frederic-fradin/default-project/desktop-tool/images/desktop-1.jpg

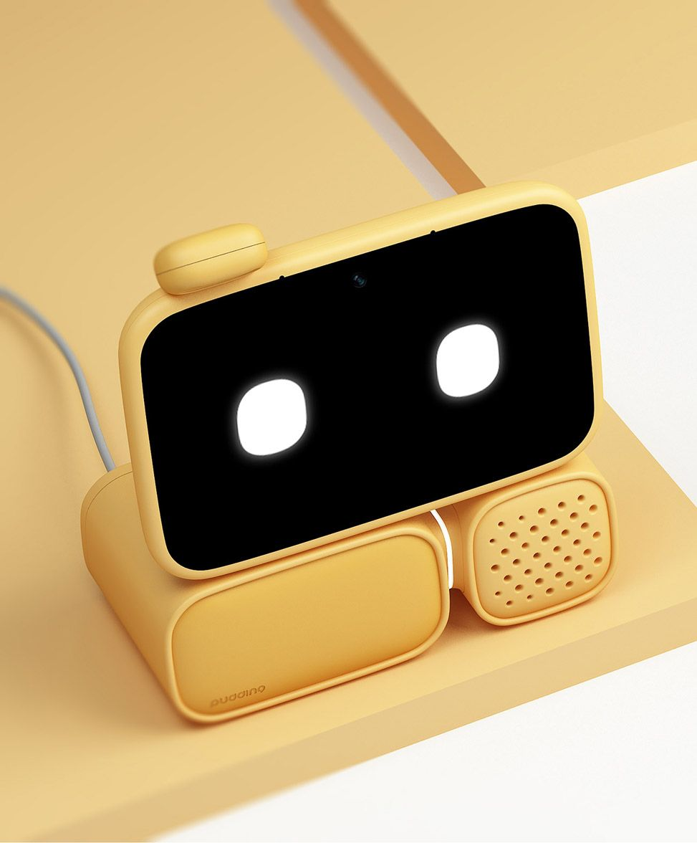
desktop-tool/images/desktop-1.jpg
