frederic-fradin/default-project/desktop-tool/images/desktop-7.jpg

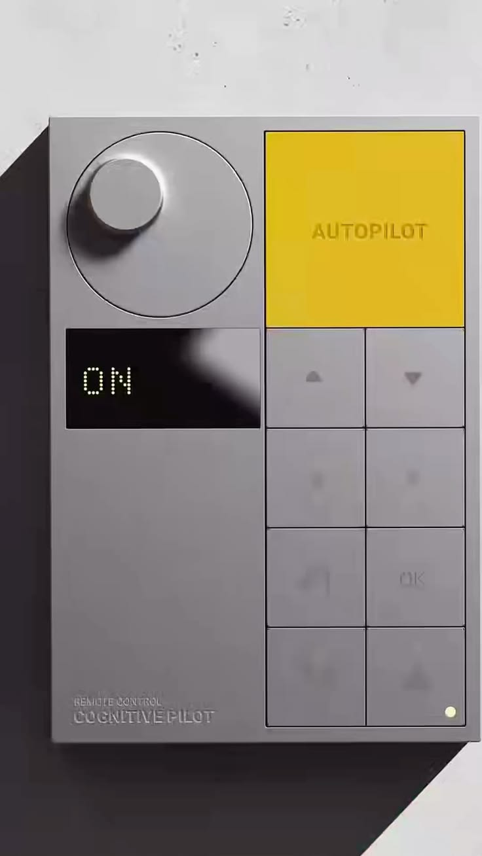
desktop-tool/images/desktop-7.jpg
