frederic-fradin/default-project/desktop-tool/README.md

# desktop-tool

Objet physique de bureau, évolutif, conçu et fabriqué de A à Z : boîtier imprimé en 3D
(Bambu Lab A1), électronique intégrée, fonctionnalités programmées.

Document de référence : [docs/cadrage.md](docs/cadrage.md)

## Arborescence

| Dossier | Contenu |
|---|---|
| `docs/` | Cadrage, journal de bord, notes techniques |
| `docs/decisions/` | Décisions structurantes (une fiche par décision, format ADR léger) |
| `cad/` | Modèles 3D sources (CAO), exports STL/3MF, profils d'impression |
| `hardware/` | Nomenclature (BOM), schémas de câblage, fiches composants |
| `firmware/` | Code embarqué de l'objet |
| `companion/` | Application compagnon Python sur le PC et simulateur de l'objet ([README](companion/README.md)) |
| `images/` | Images de référence pour le design |
