frederic-fradin/default-project/desktop-tool/docs/design/maquette-encombrement.html

desktop-tool · maquette P1 · cotes en mm

# Maquette d'encombrement du module

Le module complet en paysage (ADR 006) à l'échelle réelle : 125 × 115 × 26 mm, dos ouvert. On y monte toutes les vraies pièces (carte T5 avec son écran, NeoKey et ses 4 touches, molette, câbles QT, câble USB-C) pour vérifier que tout tient (risque R10), par où passent les câbles et où reste la place de la batterie v2. Le bas reprend le coin de module validé. Les cotes de la carte T5 viennent du plan officiel LilyGO (shell/EPD47-S3.dxf) et celles de l'écran de la fiche E Ink ED047TC1 : elles sont provisoires jusqu'à la réception de la carte.

## Façade, vue de face

échelle 2,2:1origine : coin bas gauchecarte T5 : USB-C à droite

Carte T5. 118,07 × 63,07 mm pour 120 mm de place entre les parois : moins de 1 mm de jeu de chaque côté. Elle est centrée en largeur et posée à y_t5 = 44 du bord bas, ce qui met l'écran à 10 mm du bord haut, comme sur la maquette validée. Ses coins restent sous les arrondis du haut (107 < 108) : pas de conflit avec les congés intérieurs.

Écran. La zone active (103,68 × 58,32) n'est pas centrée sur la dalle : 8,1 mm de bord côté nappe (à gauche) contre 2,1 de l'autre. Avec la carte centrée, la fenêtre a donc un bord gauche de ≈ 13 mm et un bord droit de ≈ 7,5 mm : elle s'aligne à droite sur les capuchons des touches.

Composants au dos de la carte (pointillés) : tous sont côté dos, l'avant ne porte que l'écran. Le connecteur 2×20 longe le bas de la carte, juste au-dessus de la rangée de touches ; l'échancrure du bas est sous l'antenne de l'ESP32.

## Coupe B-B, dans l'axe des broches I²C

échelle 2,4:1x = 74, vue de droite

Épaisseur. Sous la façade, l'écran et la carte occupent ≈ 2,5 mm. Il reste ≈ 21 mm jusqu'au dos, dos compris : assez pour les composants de la carte (ESP32 3,1 mm), une batterie v2 de 5 mm et les câbles.

Le point dur : le câble I²C. Le câble 4209 se branche sur le connecteur femelle 2×20, qui dépasse déjà de ≈ 8,5 mm au dos de la carte. Le boîtier noir de ses broches mâles ajoute ≈ 14 mm, plus le rayon du fil : il sortirait de ≈ 6 mm sous le dos. Valeurs standard, à confirmer en mesurant le câble dès maintenant et le connecteur à réception.

### Carte T5 · ce que dit le plan officiel

Élément | Cote | Source
Carte | 118,07 × 63,07 × 1,6 | Plan LilyGO. Le site annonce 121 × 67 × 12 : à mesurer
Échancrure sous l'antenne | 20 × 7,25 | Plan LilyGO, bord bas, à 89,7 du bord gauche
Dalle de l'écran | 113,9 × 62,5 × 0,87 | Fiche E Ink ED047TC1
Zone active | 103,68 × 58,32 | Fiche E Ink ; bords 8,1 côté nappe, 2,1 à l'opposé, ≈ 2,1 en haut et en bas
Position de la dalle sur la carte | ? | Supposée centrée : à mesurer
USB-C | centre à 39,3 du bas | Sur le petit côté droit, il dépasse la carte de ≈ 1 mm
Connecteur 2×20 (SDA 18, SCL 17) | x 26 → 76, y 1,4 → 5,8 | Au dos, le long du bord bas ; broches 17/18 vers x ≈ 70
Prise P5, PH 2,0 4 broches | x 27,6 → 36,6, en haut | Schéma V2.3 : 3,3 V, IO15, IO16, GND
Prise P4, PH 2,0 4 broches | x 38,4 → 47,3, en haut | Schéma : 3,3 V, MISO, SCLK, GND (bus SPI)
Boutons RST, BOOT, IO | bord haut | Au dos : inaccessibles une fois le dos fermé
Trous de fixation | aucun | Aucun trou sur le plan : la carte sera tenue par des pattes

Positions données depuis le coin bas gauche de la carte, vue de face, USB-C à droite.

### Choix (2026-10-04)

#### 1 · Sens de la carte ✅

Retenu : USB-C à droite, connecteur 2×20 en bas. Le câble sort du côté opposé à la main gauche, et le connecteur I²C est près des touches. L'autre sens (USB-C à gauche) inverserait aussi les bords de l'écran (≈ 7,5 à gauche, ≈ 13 à droite).

#### 2 · Branchement I²C ✅

Boîtier des broches du 4209 mesuré à 14 mm : il ne tient pas. Retenu : prise P5 (IO15/IO16), avec le câble Adafruit 4424, JST PH 4 broches ↔ STEMMA QT (≈ 3 €, hors budget accepté). Ordre des fils à refaire avant de brancher (voir hardware/bom.md). Elle est basse, en haut de la carte, et l'ESP32-S3 accepte l'I²C sur n'importe quelles broches (Wire.begin(15, 16)). Écarté : le câble 4209 avec une fente dans le dos.

#### 3 · Hauteur de l'écran ✅

Retenu : y_t5 = 44, l'écran à 10 mm du bord haut, comme la maquette validée, avec ≈ 16 mm entre les capuchons et le bas de l'écran. Plus bas (y_t5 = 34, le minimum à cause des plots de la molette), l'écran se rapproche des touches mais le bord haut passe à ≈ 20 mm.

#### 4 · Constat : USB-C sur le côté

L'USB-C de la carte sort par le côté droit, pas au dos comme prévu par les ADR 005 et 006 (branchement par la lame de la station). Rien à décider tant que la station est en attente, mais il faudra mettre ces ADR à jour.

### Paramètres à ajouter · fichier module-maquette

Nom | Valeur | Rôle
h_module | 115 mm | Remplace h_test (40) : hauteur du module
l_t5 | 118,07 mm | Longueur de la carte T5 (à mesurer)
w_t5 | 63,07 mm | Largeur de la carte T5 (à mesurer)
x_t5 | 3,465 mm | Formule (l_module - l_t5) / 2 : carte centrée
y_t5 | 44 mm | Bas de la carte depuis le bord bas (écran à 10 mm du bord haut)
ep_t5_avant | 2,5 mm | Écran 0,87 + carte 1,6 (à mesurer) : hauteur des plots de la carte
aa_l / aa_h | 103,68 / 58,32 mm | Zone active de l'écran (fiche E Ink)
aa_x | 10,2 mm | Bord gauche de la zone active depuis le bord gauche de la carte (provisoire, à mesurer)
aa_y | 2,4 mm | Bas de la zone active depuis le bas de la carte (provisoire, à mesurer)
marge_fen | 0,5 mm | Fenêtre un peu plus grande que la zone active, de chaque côté
usb_y | 39,3 mm | Centre de l'USB-C depuis le bas de la carte (plan LilyGO)
usb_z | 19,4 mm | Axe de l'USB-C depuis le dos (provisoire, à mesurer)
usb_l / usb_h | 13 / 7,5 mm | Trou pour la fiche surmoulée du câble, jeu compris (à mesurer sur ton câble)

### Mesures à prendre

#### Dès maintenant

- Câble 4209 : longueur du boîtier noir d'une broche mâle, broche non comprise.
- Câble USB-C : largeur × épaisseur de la fiche surmoulée, et longueur avant le coude s'il est coudé.

#### À réception de la carte T5

- Longueur, largeur et épaisseur totale écran + carte, sans les composants.
- Position de la zone active (la partie qui change d'aspect) : distance aux 4 bords de la carte.
- Hauteur au dos : connecteur 2×20, ESP32, condensateur rond près de l'USB-C, prises P4/P5.
- USB-C : centre depuis le bas de la carte, hauteur de son axe depuis l'avant de l'écran, dépassement du bord.
- P5 : prise droite ou coudée, et ordre des fils (3,3 V, IO15, IO16, GND).
- Les bords haut et bas de la carte sont-ils libres de composants aux endroits des pattes ?

### Étapes dans Fusion · fichier module-maquette

1. Ouvrir coin-module, Fichier › Enregistrer sous module-maquette : le coin reste intact.
2. Modifier les paramètres : renommer h_test en h_module et le passer à 115, puis créer les paramètres ci-dessus.
3. Congé : double-clic sur le congé dans la timeline, ajouter les 2 arêtes verticales du haut. Les 4 coins sont arrondis à r_module.
4. Coque : double-clic sur la coque dans la timeline, désélectionner la face du haut et ne garder que le dos. Il reste la façade et 4 parois.
5. Fenêtre de l'écran : esquisse sur la façade, Rectangle 2 points, premier coin en x = x_t5 + aa_x - marge_fen, y = y_t5 + aa_y - marge_fen, de aa_l + 2 * marge_fen × aa_h + 2 * marge_fen. Couper de ep_paroi.
6. Plots de la carte : retourner la vue, esquisse sur la face intérieure de la façade, 4 cercles de d_plot : en bas à y = y_t5 - 3, x = 12 et 86,5 ; en haut à y = y_t5 + w_t5 + 2,7, x = 12 et 113. Extruder en « Joindre » de ep_t5_avant.
7. Avant-trous : d_pilote concentriques, Couper de 4. Il reste 1 mm de façade sous la vis.
8. Trou de l'USB-C : esquisse sur la face extérieure de la paroi droite, rectangle centré de usb_l × usb_h, à y_t5 + usb_y du bord bas et usb_z du dos. Couper de ep_paroi.
9. Enregistrer. Pas d'export avant la réception de la carte et la mise à jour des cotes provisoires.

### Tenue de la carte · pattes

La carte n'a pas de trou : 4 pattes imprimées à part la plaquent contre la façade par le dos. Chaque patte (8 × 10 × 2, trou Ø 2,4) se visse sur un plot de la carte et recouvre son bord de 2 mm. Les plots se placent hors de la carte, aux endroits libres de ses bords haut et bas (pas sur les côtés : moins de 1 mm de jeu). Serrer sans forcer : la dalle est en verre et ses coins sont fragiles.

### Impression

- À réception de la carte et après les mesures. 0.20mm Standard, plaque texturée, façade contre le plateau, 4 boucles de paroi, sans support. 125 × 115 tient sur le plateau de l'A1 (256 × 256).

### À noter après le test

- Carte : entre-t-elle entre les parois ? La fenêtre tombe-t-elle sur la zone active, sans bord blanc ni pixel caché ?
- Câbles : par où passent les câbles QT (carte → touches → molette) ? Rien ne force ?
- USB-C : la fiche entre-t-elle à fond par le trou de la paroi ?
- Place restante : une batterie 5 × 40 × 60 tient-elle derrière la carte, sous les câbles ?
- Prise en main : poids, équilibre, aspect de la façade avec l'écran.
