frederic-fradin/default-project/desktop-tool/docs/design/maquettes.html

desktop-tool · planches de conception · cotes en mm

# Le module et sa station modulaire

Le module se pose sur une station modulaire : un socle bas percé de trous ronds sur toute sa surface, sur lequel se clipsent le pupitre du module et le pupitre MagSafe du téléphone ; 2 colonnes restent libres pour un futur élément. La station prend la couleur du corps du module (ADR 005).

## Le module

retenu125 × 115 × 26 · paysagetouches neutres · ADR 004

Tourné de 90° vers la gauche après une impression test à l'échelle : écran en paysage en haut, molette en bas à gauche, sous le pouce gauche quand on le tient, et 4 touches en ligne en bas à droite. Dos plat avec 4 aimants et port USB-C. Les pointillés montrent la carte, la batterie (v2), le module de touches et l'encodeur. Touches à symboles neutres gravés en creux (1, 2, 3 barres, maison) ; leur fonction s'affiche en bas de l'écran, juste au-dessus de chaque touche.

## Style B · Muted White + orange

à confirmer par impression testsur la station modulaireteintes approximatives à l'écran

### Module

- Corps et touches : Muted White
- Symboles des touches : gravés en creux, sans couleur

### Accent

- Molette : Sunrise Orange

### Station

- Muted White, comme le corps du module : l'ensemble se lit comme un seul objet

## Style C · gris chaud + orange

d'après l'image desktop-9sur la station modulaireteintes approximatives à l'écran

### Module

- Corps : Ash Grey, gris mat
- Touches : Muted White, symboles fins gravés en creux, sans couleur

### Accent

- Molette : Sunrise Orange, seul point de couleur

### Station

- Ash Grey, comme le corps du module

## F · Station modulaire

piste retenuesocle 250 × 90 × 1048 trous ronds au pas de 20 mmiPhone 13 Pro en portrait

### Socle

- Dalle de 250 × 90 × 10 mm, aux arrondis du module : 12 colonnes, le maximum posé droit sur l'A1 (256 mm)
- Percée sur toute sa surface : 48 trous ronds Ø 10 × 6 mm (12 colonnes × 4 rangées), au pas de 20 mm, 15 mm de marge au bord
- Profondeur calée sur celle des semelles : un élément couvre les 4 rangées, aucun trou ne reste vide devant ou derrière lui
- Pas de rainure à stylo : un futur élément peut accueillir le stylo n'importe où
- Imprimé seul, à plat

### Élément · pupitre module

- 6 colonnes ; semelle de 3 mm et 4 tenons ronds clipsables aux coins (Ø 9,6 × 6, fendus, avec ergot)
- Lame d'appui à 65° avec renfort ; assise sous l'arête basse, face avant en pente douce jusqu'à la semelle
- Connecteur USB-C magnétique noyé dans la lame, face au port du dos du module ; câble en gorge au dos de la lame puis sous la semelle

### Élément · pupitre MagSafe

- 4 colonnes ; semelle de 3 mm et 4 tenons ronds aux coins
- Lame de 62 × 112 mm, empreinte Ø 56,5 × 5,5 pour le palet, centré à 75 mm du bas
- iPhone 13 Pro avec coque (74 × 149 × 12 mm) : il déborde de 6 mm de chaque côté de la lame, qui reste invisible de face
- Assise de 14 mm sous le téléphone, face avant en pente douce, sans rebord devant : le palet MagSafe suffit à le tenir

### Emplacement libre · 2 colonnes

- À droite du téléphone, ≈ 40 mm de large sur toute la profondeur
- Usage à définir : boîte à crayons, repose-stylo, vide-poche…
- Le support AirPods a été écarté

### Modularité

- Chaque élément se clipse n'importe où dans la largeur : on peut le décaler par pas de 20 mm ou intervertir les éléments
- Trous ronds : un tenon rond se clipse sans orientation imposée, et un élément peut pivoter sur un seul tenon (un porte-stylo orientable, par exemple)
- 12 colonnes : 6 pour le module, 4 pour le téléphone, 2 libres ; au-delà (repose-stylo, vide-poche, logement de batterie en v2), une rallonge de socle clipsable, reliée par des pions dans les trous de bord
- Tenons à valider par une pièce test : jeu de 0,2 mm par côté, ergot de 0,4 mm ; en secours, 2 aimants Ø 6 × 3 par élément

### À trancher

- Palet MagSafe : déjà possédé ✅, aucun achat
- Connecteur USB-C magnétique (données + charge) et rallonge sur panneau : ≈ 10 à 15 € hors budget, à valider avec la position réelle du port de la carte T5

## Couleurs · filaments Panchroma en stock

station de la couleur du moduleteintes approximatives à l'écran

### 1 · Atelier

- Module et station Cotton White
- Touches Fossil Grey, molette Sunrise Orange
- Clair et lumineux, esprit « objet design »

### 2 · Nuit

- Module et station Charcoal Black
- Touches Ash Grey, molette Sunrise Orange
- L'image 3 : sobre, l'écran clair ressort fortement

### 3 · Pierre

- Module et station Fossil Grey
- Touches Muted White, molette Army Red
- Tons minéraux, accent discret

### 4 · Sauge

- Module et station Muted White
- Touches Muted White, molette Army Blue
- Doux et chaleureux, le plus original

Études précédentes (pupitre triangle, pupitres allégés, pupitres A, B, C, variantes)

## Pupitre · module incrusté

abandonné · ADR 005face et dos à 55°empreinte de 26 mm (100 %)bordures droite et basse 25 mmhaut du pupitre 36 mm sous le module

### Principe

- Volume plein, en triangle symétrique de profil : la face et le dos ont la même pente (55°)
- Une empreinte à la forme du module, profonde de 26 mm : il s'y incruste sur toute son épaisseur, sa façade affleure celle du pupitre ; seules les touches et la molette dépassent
- Aucun rebord devant la façade : le module repose sur la paroi basse, s'appuie sur la paroi droite, et les aimants le plaquent au fond

### Prise en main

- Empreinte ouverte à gauche et en haut : le module dépasse de 12 mm à gauche et de 36 mm en haut
- Le pupitre s'étend de 25 mm à droite et de 25 mm sous le module : les deux bordures visibles ont la même largeur

### À régler en P1

- Jeu de l'empreinte : 0,5 mm par côté, à valider par une pièce test
- Arrondis du fond de l'empreinte et congés des arêtes (2 à 3 mm) dessinés dans Fusion

## Pupitres allégés · 3 pistes

la piste F est devenue la station modulairepalette 5C

### D · Béquille · 65°

- Le module se pose directement sur le bureau ; une fine béquille de 5 mm s'aimante sur son dos
- Pour : le plus léger, rien de visible de face, le module reste un objet autonome
- Contre : il repose sur son arête basse (patins antidérapants) ; la béquille doit tenir l'appui sur les touches

### E · Ailettes · 55°

- Deux ailettes de 6 mm cachées derrière le module, terminées par deux petites griffes qui le portent
- Pour : le module semble flotter à 10 mm du bureau ; de face on ne voit que les deux griffes
- Contre : les griffes mordent 6 mm sur le bas de la façade ; deux pièces à imprimer, à relier (entretoise ou plaque aimantée)

### F · Plateau · 65°

- Une dalle de 8 mm aux mêmes arrondis que le module ; le module s'appuie sur une lame arrière
- Pour : très stable, la dalle déborde de 30 mm à droite en vide-poche ; allure de socle d'objet
- Contre : la plus grande emprise sur le bureau ; la cale avant reste visible sous le module

## Pupitre A · Berceau en L

55°décalé de 30 mm à droite

### Principe

- Plaque arrière, rebord bas et flanc droit qui reprennent les arrondis du module
- Le module se dépose contre le flanc droit, sans avoir à viser

### Pour

- Module bien guidé et bien tenu
- Bord gauche libre sur 30 mm pour le saisir

### Contre

- Le plus massif des trois
- Pied arrière visible de côté

## Pupitre B · Socle à fente

70°décalé de 35 mm à droite

### Principe

- Bloc bas posé à plat, sous la partie écran
- Le module se glisse d'en haut dans une fente inclinée, comme un cadre ou une radio

### Pour

- Très compact, allure d'objet de design
- Aucun pied : la stabilité vient du bloc
- En v2, le fond de la fente peut accueillir la charge

### Contre

- Fente à imprimer avec un jeu précis
- Le module doit être levé pour sortir

## Pupitre C · Dos décalé

75°décalé de 16 mm à droite et 9 mm en bas

### Principe

- Une plaque au contour identique au module, décalée comme une ombre portée
- Le module s'y aimante et repose sur un fin rebord

### Pour

- Le plus léger et le plus graphique
- Effet de calque fidèle à l'esprit de l'image 5

### Contre

- Presque vertical : moins stable quand on appuie sur les touches
- Le décalage laisse moins de place à gauche

## Variante 1 · Colonne

115 × 125 × 26

## Variante 2 · Molette sur la tranche

105 × 125 × 26

## Variante 3 · Grandes touches

112 × 125 × 26

Batterie. Emplacement dimensionné pour une LiPo plate de type 504060 (5 × 40 × 60 mm, ≈ 2 000 mAh), à acheter en v2. La carte intègre la charge, mais pas de circuit de protection : il faudra une batterie protégée.

Sans-fil. Le Wi-Fi et le Bluetooth sont intégrés à l'ESP32-S3 : aucun composant ni volume supplémentaire. Il faut simplement éviter les aimants et le métal près de l'antenne de la carte.

Touches (ADR 004). Symboles neutres, petits et discrets, gravés en creux sans couleur : 1, 2 et 3 barres (0,8 × 5 mm, écart 1,5 mm), maison de 5 mm sur la 4e, seule fonction fixe. Touches imprimées face visible contre le plateau. La fonction de chaque touche s'affiche en bas de l'écran, juste au-dessus d'elle : MUET, CAPTURE et OUTLOOK sont des exemples, qui peuvent changer d'une page à l'autre.
