frederic-fradin/default-project/desktop-tool/docs/decisions/002-logiciel-cao-fusion.md

# 002 — Logiciel de conception 3D : Fusion

| | |
|---|---|
| **Date** | 2026-09-26 |
| **Statut** | ✅ Acceptée |

## Contexte

Je débute sur Blender. Le boîtier demande des cotes précises : découpe de l'écran, jeu des
touches sur les switches, clips, logements d'aimants. J'ai 4 h par semaine, donc je ne veux
apprendre qu'un seul outil.

## Options étudiées

1. **Blender** : excellent pour les formes organiques et les rendus, mais modeleur de maillage,
   peu adapté aux cotes précises et aux itérations.
2. **Fusion** : CAO paramétrique (changer une cote met tout le modèle à jour), licence
   « Personal Use » gratuite pour un usage non commercial.
3. **Onshape** : CAO paramétrique gratuite dans le navigateur, mais les documents de l'offre
   gratuite sont publics.

## Décision

**Fusion**, en licence personnelle gratuite.

## Conséquences

- ✅ Modifications de cotes rapides lors des itérations d'impression.
- ✅ Export direct en 3MF / STL pour Bambu Studio.
- ❌ Nouvel outil à apprendre (pièces d'exercice prévues en P1).
- ❌ Licence personnelle à renouveler chaque année, usage non commercial uniquement.
