frederic-fradin/default-project/desktop-tool/cad/canvas/bouton_coupe_XZ.png

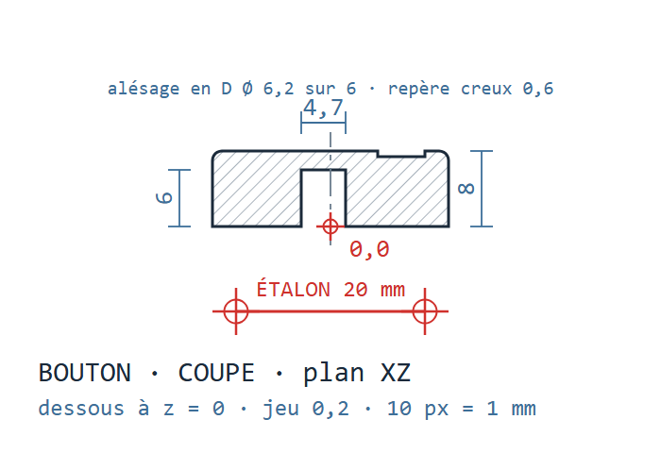
desktop-tool/cad/canvas/bouton_coupe_XZ.png
