frederic-fradin/default-project/desktop-tool/cad/canvas/bouton_dessus_XY.png

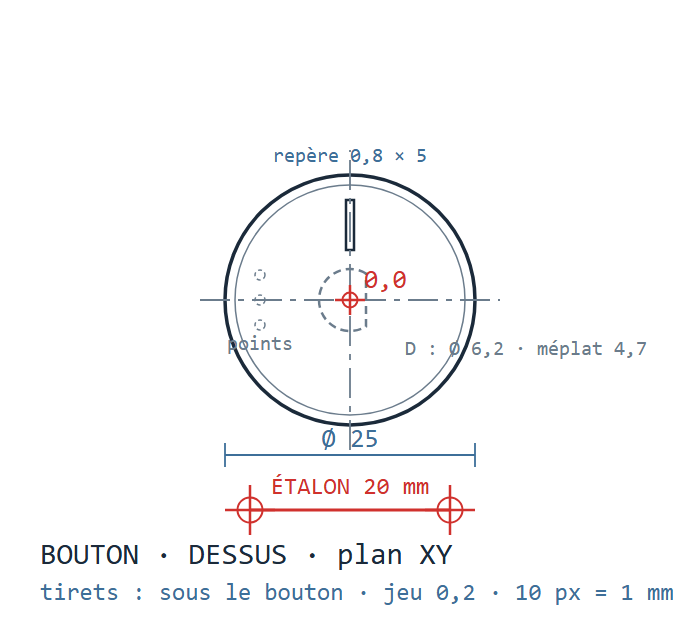
desktop-tool/cad/canvas/bouton_dessus_XY.png
