frederic-fradin/default-project/desktop-tool/cad/canvas/coin-module_coupe_XZ.png

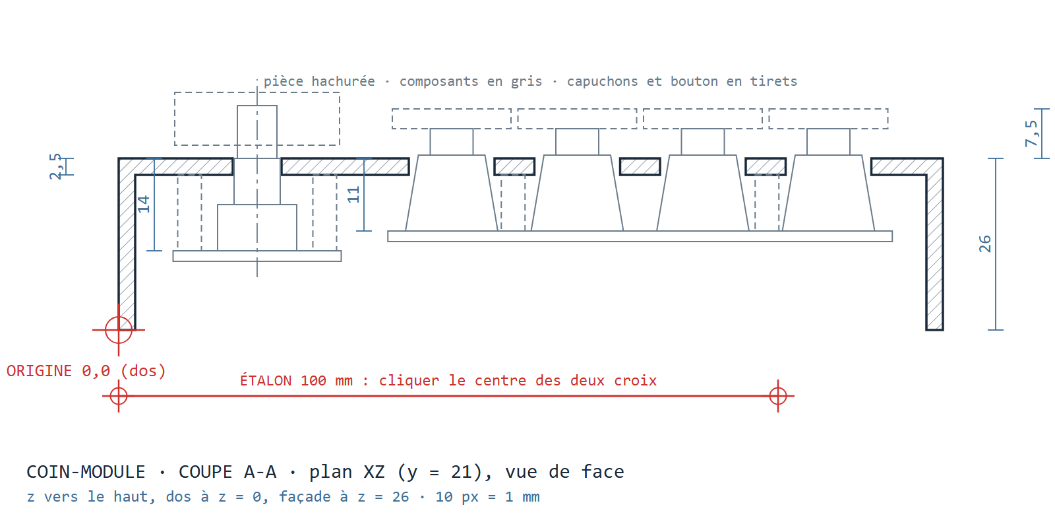
desktop-tool/cad/canvas/coin-module_coupe_XZ.png
