frederic-fradin/default-project/desktop-tool/cad/canvas/coin-module_facade_XY.png

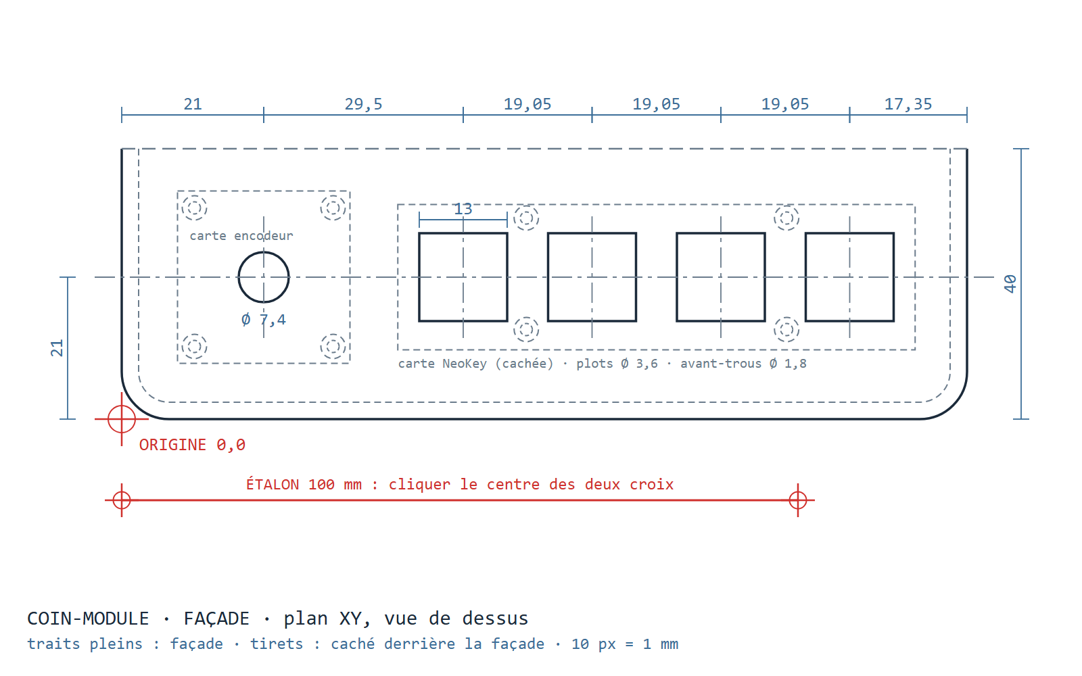
desktop-tool/cad/canvas/coin-module_facade_XY.png
