frederic-fradin/default-project/desktop-tool/images/desktop-2.jpg

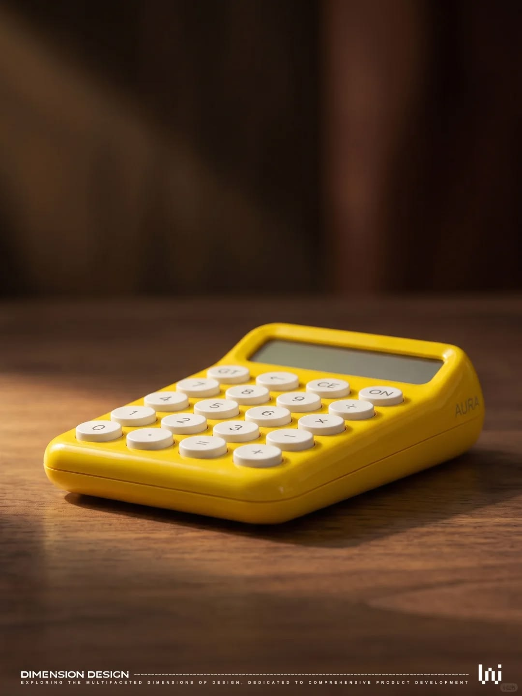
desktop-tool/images/desktop-2.jpg
