frederic-fradin/default-project/desktop-tool/images/desktop-4.jpg

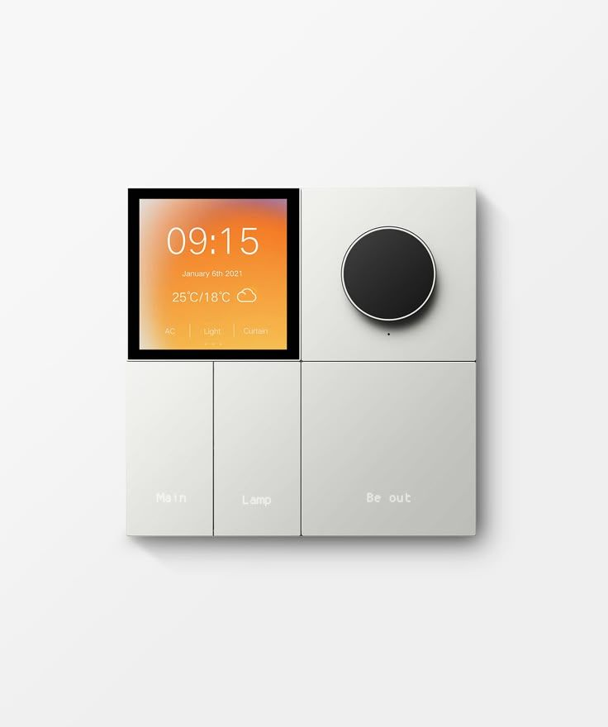
desktop-tool/images/desktop-4.jpg
