frederic-fradin/default-project/desktop-tool/images/desktop-5.jpg

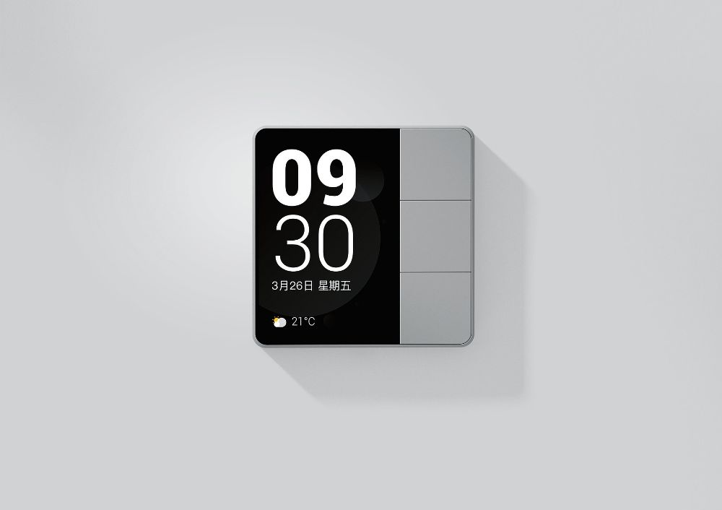
desktop-tool/images/desktop-5.jpg
