frederic-fradin/default-project/desktop-tool/images/desktop-6.jpg

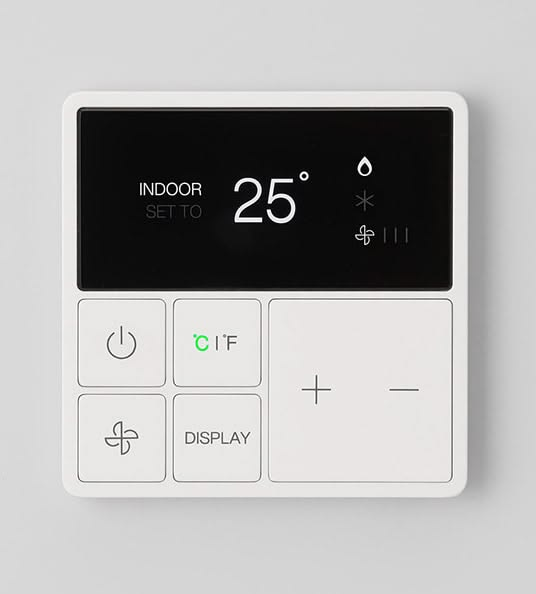
desktop-tool/images/desktop-6.jpg
