frederic-fradin/default-project/desktop-tool/images/desktop-8.jpg

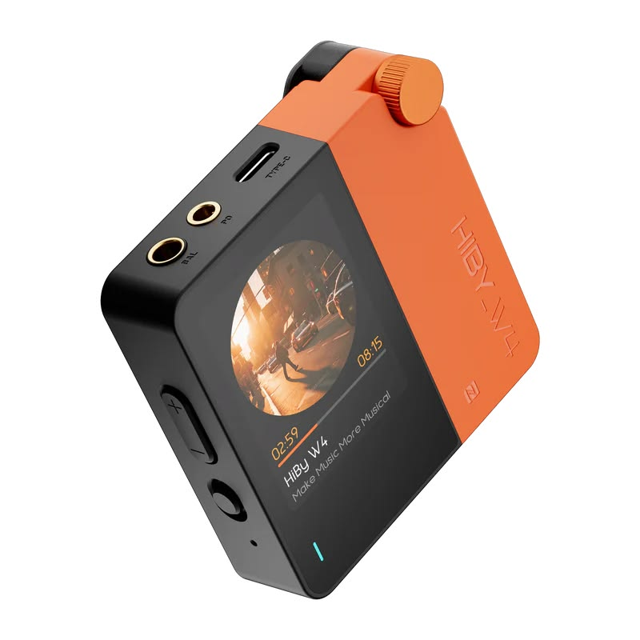
desktop-tool/images/desktop-8.jpg
