frederic-fradin/default-project/desktop-tool/images/desktop-9.jpg

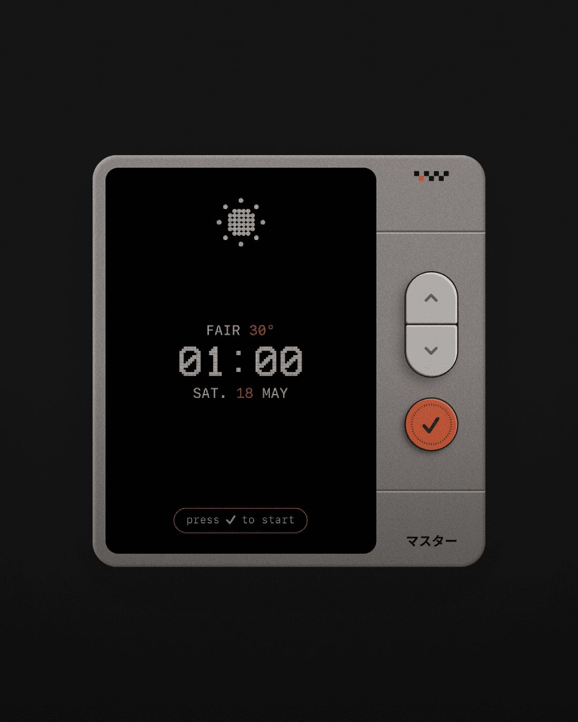
desktop-tool/images/desktop-9.jpg
