frederic-fradin/default-project/desktop-tool/cad/tuile-couleur.3mf

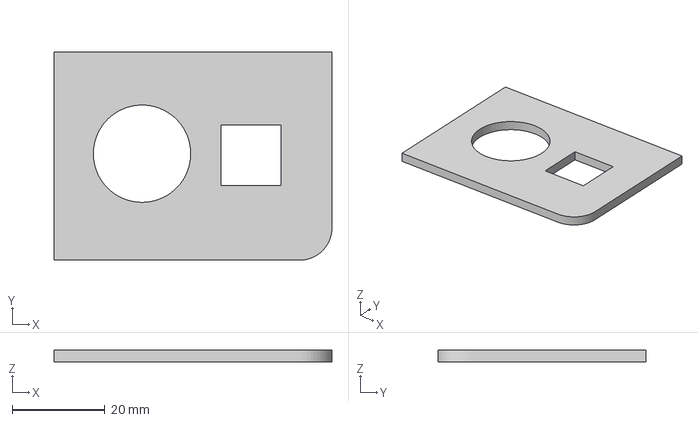
[picture p13: CAD file, 2026-10-04]
desktop-tool/cad/tuile-couleur.3mf
60.0 x 45.0 x 2.50 mm
