frederic-fradin/default-project/desktop-tool/cad/module-maquette.3mf

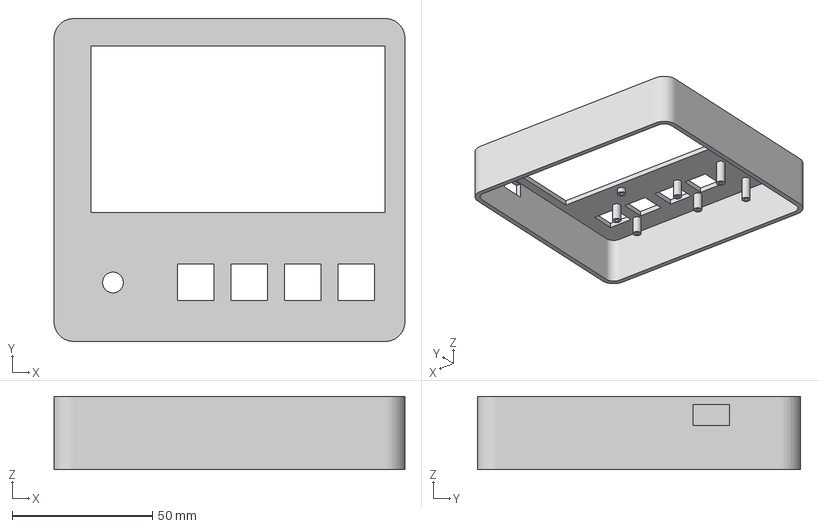
[picture p14: CAD file, 2026-10-04]
desktop-tool/cad/module-maquette.3mf
125.0 x 115.0 x 26.0 mm
