frederic-fradin/default-project/desktop-tool/cad/coin-module.3mf

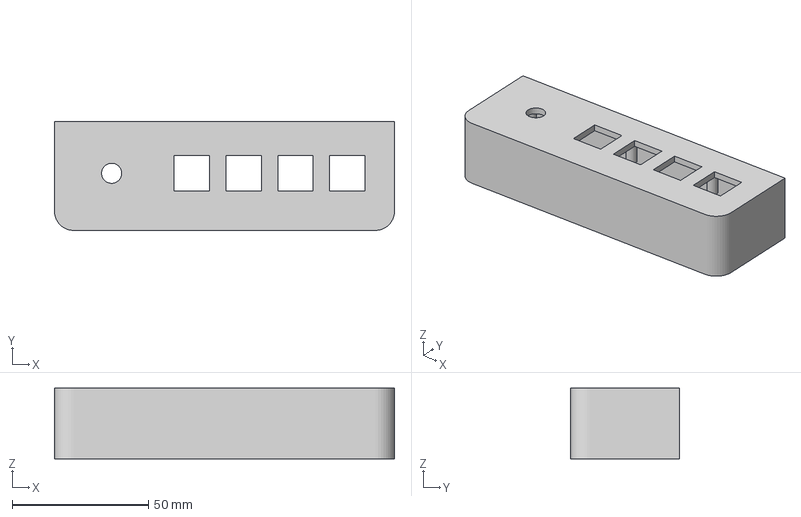
[picture p15: CAD file, 2026-10-04]
desktop-tool/cad/coin-module.3mf
125.0 x 40.0 x 26.0 mm
