frederic-fradin/default-project/desktop-tool/cad/bouton-molette.3mf

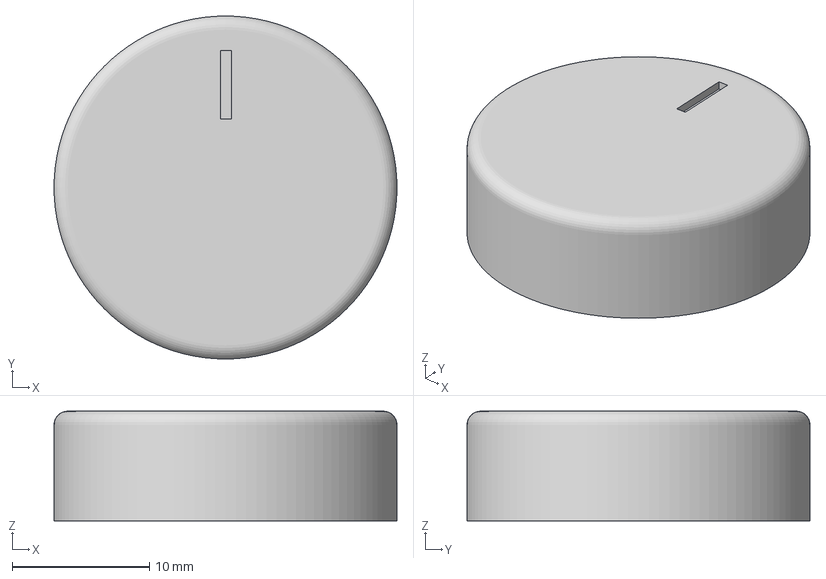
[picture p16: CAD file, 2026-10-04]
desktop-tool/cad/bouton-molette.3mf
25.0 x 25.0 x 8.00 mm
