frederic-fradin/default-project/desktop-tool/cad/plaquette-plots.3mf

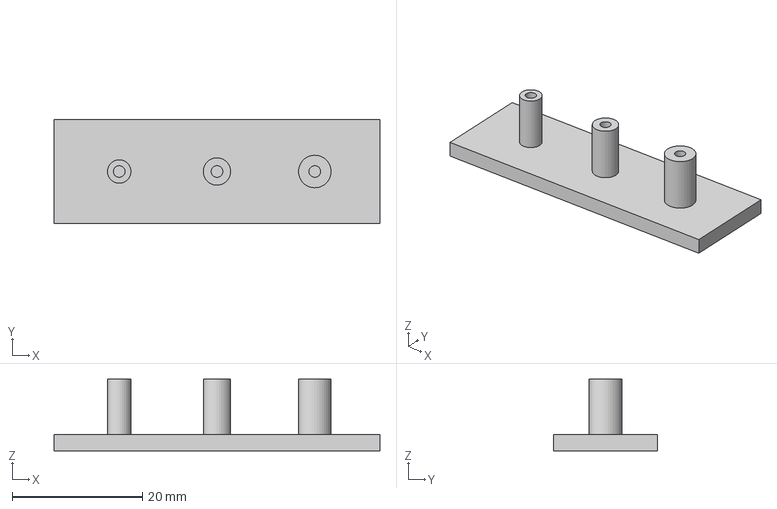
[picture p17: CAD file, 2026-10-04]
desktop-tool/cad/plaquette-plots.3mf
50.0 x 16.0 x 11.0 mm
