frederic-fradin/default-project/desktop-tool/cad/capuchons.3mf

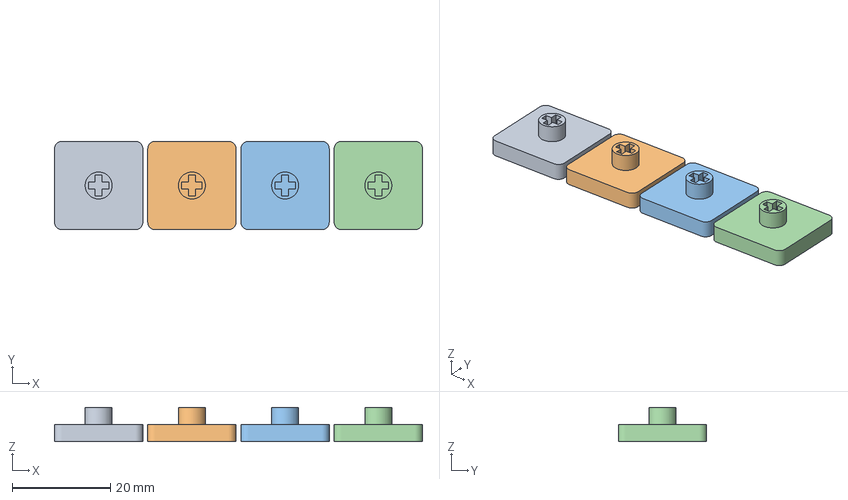
[picture p18: CAD file, 2026-10-03]
desktop-tool/cad/capuchons.3mf
75.0 x 18.0 x 7.00 mm
Corps12
Corps14
Corps15
Corps16
