frederic-fradin/default-project/desktop-tool/cad/plaquette-test.3mf

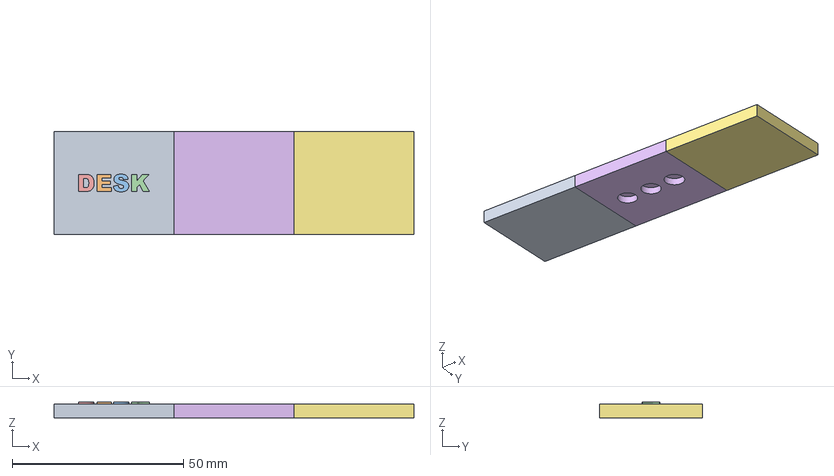
[picture p19: CAD file, 2026-09-27]
desktop-tool/cad/plaquette-test.3mf
105.0 x 30.0 x 4.60 mm
Blanc
Corps4
Corps5
Corps6
Corps7
Gris
Orange
