frederic-fradin/default-project/(list of files, cad)

Other CAD files:
desktop-tool/cad/bouton-molette.f3d
desktop-tool/cad/capuchons.f3d
desktop-tool/cad/coin-module.f3d
desktop-tool/cad/module-maquette.f3d
desktop-tool/cad/plaquette-plots.f3d
desktop-tool/cad/plaquette-test.f3d
desktop-tool/cad/tuile-couleur.f3d
