frederic-fradin/default-project/desktop-tool/docs/design/coin-module-test.html

desktop-tool · pièce test P1 · cotes en mm

# Coin de module test

Le bas du module en paysage (ADR 006) à l'échelle réelle : 125 mm de large, 40 mm de haut, 26 mm d'épaisseur, dos ouvert. On y visse la vraie NeoKey avec ses 4 touches et la vraie molette, pour valider l'accès au pouce gauche, la hauteur des commandes et leur fixation. Un bouton de molette est imprimé à part, en 3 variantes de jeu. Cotes tirées des mesures du 2026-10-03.

## Façade, vue de face

échelle 2,5:1origine : coin bas gauche

Repère. Toutes les positions partent du coin bas gauche du module, vu de face. La molette et la rangée de touches sont alignées à 21 mm du bord bas, comme sur la maquette. En pointillés : les cartes et les plots cachés derrière la façade, le capuchon et le bouton.

## Coupe A-A, dans l'axe des commandes

échelle 2,4:1touches au repos

Touches. La carte NeoKey est à 11 mm sous le dessus de la façade. Le haut du boîtier des switches dépasse de 0,5 mm dans sa fenêtre, et un capuchon enfoncé s'arrête juste au-dessus : rien ne touche la façade. Les touches dépassent de 7,5 mm au repos.

Molette. La carte de l'encodeur est à 14 mm sous le dessus de la façade : la bague filetée affleure, l'écrou reste dans le sachet. Le bouton laisse 2 mm sous lui pour la course du clic (0,5 mm) : 1 mm ne suffisait pas au premier test.

## Bouton de molette

échelle 3,5:1jeu 0,2 · version 2

Alésage. Le méplat de l'axe Ø 6 court sur 7 mm, toute la longueur engagée dans le bouton : l'alésage est en D sur toute sa profondeur. Le jeu s'ajoute au diamètre et à l'épaisseur sur le méplat, comme pour la croix des touches. Version 2 : alésage de 6, bouton de 8 de haut.

### Paramètres · fichier coin-module

Nom | Valeur | Rôle
l_module | 125 mm | Largeur du module
h_test | 40 mm | Hauteur de la tranche imprimée
ep_module | 26 mm | Épaisseur du module, façade comprise
r_module | 7 mm | Arrondi des coins
ep_paroi | 2,5 mm | Façade et parois
y_commandes | 21 mm | Axe de la molette et des touches, depuis le bord bas
x_molette | 21 mm | Axe de la molette, depuis le bord gauche
x_touche1 | 50,5 mm | Axe du switch 1, depuis le bord gauche
pas_touche | 19,05 mm | Entraxe des switches
fen_switch | 13 mm | Fenêtre carrée autour de chaque switch
l_neokey | 76,5 mm | Longueur de la carte NeoKey
w_neokey | 21,5 mm | Largeur de la carte NeoKey
marge_switch | 9,675 mm | Formule (l_neokey - 3 * pas_touche) / 2
x_neokey | 40,825 mm | Formule x_touche1 - marge_switch
y_neokey | 10,25 mm | Formule y_commandes - w_neokey / 2 (switches centrés sur la carte, mesuré : 10,75 au bord haut)
trou_nk_x | 19 mm | Centre des trous NeoKey, depuis chaque bout
trou_nk_y_bas | 3 mm | Centre des trous NeoKey, depuis le grand côté des coins arrondis
trou_nk_y_haut | 2 mm | Centre des trous NeoKey, depuis le grand côté de l'écran (3 au premier test : 1 mm trop bas)
prof_neokey | 11 mm | Dessus de la carte sous le dessus de la façade
c_encodeur | 25,5 mm | Côté de la carte de l'encodeur
trou_enc | 2,5 mm | Centre des trous de l'encodeur, depuis les bords
prof_encodeur | 14 mm | Dessus de la carte sous le dessus de la façade (bague affleurante)
d_bague | 7 mm | Bague filetée de l'encodeur
jeu_bague | 0,2 mm | Jeu au rayon autour de la bague
d_plot | 3,6 mm | Plots de fixation, fins pour passer entre les switches. Tient avec l'avant-trou de 1,8 et 4 parois (plaquette de plots, 2026-10-04)
d_pilote | 1,8 mm | Avant-trou pour vis M2 auto-taraudeuse (1,6 forçait trop)

### Paramètres · fichier bouton-molette

Nom | Valeur | Rôle
d_bouton | 25 mm | Diamètre du bouton
h_bouton | 8 mm | Hauteur du bouton (9 au premier test) : le dessus reste à 10 mm au-dessus de la façade
r_conge | 1 mm | Congé de l'arête du dessus
d_axe | 6 mm | Axe mesuré
e_meplat | 4,5 mm | Épaisseur de l'axe sur le méplat
l_meplat | 7 mm | Longueur du méplat depuis le bout, mesurée : au moins p_alesage, d'où un alésage en D sur toute sa profondeur
p_alesage | 6 mm | Profondeur de l'alésage : le bouton flotte 2 mm au-dessus de la façade (7 au premier test : 1 mm sous le bouton, il frottait et le clic ne passait pas)
jeu_axe | 0,1 / 0,2 / 0,3 mm | Une valeur par variante

### Étapes dans Fusion · fichier coin-module

1. Modifier › Modifier les paramètres : créer les paramètres du premier tableau.
2. Bloc : esquisse sur le plan XY, Rectangle 2 points, premier coin sur l'origine, de l_module × h_test. Extruder de ep_module vers le haut : le dessus du bloc est la façade.
3. Congé de r_module sur les 2 arêtes verticales du bord bas (y = 0).
4. Modifier › Coque : cliquer la face du dessous (le dos) et la face du haut (y = h_test), épaisseur ep_paroi, vers l'intérieur. Il reste la façade et 3 parois.
5. Fenêtres : esquisse sur la façade, rectangle à partir du centre de fen_switch × fen_switch, centré à x_touche1 du bord gauche et à y_commandes du bord bas, vu de dessus (bord gauche = côté de la molette, bord bas = côté des coins arrondis). Extruder en « Couper » de ep_paroi. Puis Créer › Réseau › Réseau rectangulaire, type d'objet Fonctions, cette découpe, quantité 4, espacement pas_touche sur l'axe X.
6. Trou de la bague : esquisse sur la façade, cercle de d_bague + 2 * jeu_bague centré à x_molette du bord gauche et à y_commandes du bord bas. Couper de ep_paroi.
7. Plots NeoKey : retourner la vue, esquisse sur la face intérieure de la façade. 4 cercles de d_plot en x = x_neokey + trou_nk_x et x_neokey + l_neokey - trou_nk_x, y = y_neokey + trou_nk_y_bas et y_neokey + w_neokey - trou_nk_y_haut. Extruder en « Joindre » vers le dos de prof_neokey - ep_paroi (8,5).
8. Plots encodeur : même principe, 4 cercles en x_molette ± (c_encodeur / 2 - trou_enc), y_commandes ± (c_encodeur / 2 - trou_enc). Extruder de prof_encodeur - ep_paroi (11,5).
9. Avant-trous : esquisse sur le bout des plots NeoKey, 4 cercles de d_pilote concentriques, Couper de 6. Idem sur les plots de l'encodeur.
10. Enregistrer sous cad/coin-module, exporter en .3mf.

### Étapes dans Fusion · fichier bouton-molette

1. Modifier › Modifier les paramètres : créer les paramètres du second tableau, avec jeu_axe = 0,2 mm.
2. Esquisse sur le plan XY : cercle de d_bouton centré sur l'origine. Extruder de h_bouton vers le haut. Congé de r_conge sur l'arête du dessus.
3. Alésage en D : esquisse sur la face du dessous, cercle de d_axe + jeu_axe centré, et une ligne verticale qui le coupe à (e_meplat + jeu_axe) - (d_axe + jeu_axe) / 2 du centre (1,6). Couper le grand morceau du cercle de p_alesage.
4. Repère : esquisse sur le dessus, rectangle de 0,8 de large, de 5 à 10 mm du centre. Couper de 0,6.
5. Points de variante : esquisse sur le dessous, 3 cercles Ø 1 alignés à 9 mm du centre, du côté opposé au méplat, espacés de 2,5. Couper de 0,4 en ne sélectionnant que 1, 2 ou 3 disques selon la variante.
6. Version 2 : passer h_bouton à 8 et p_alesage à 6 dans Modifier les paramètres, garder jeu_axe à 0,2 (2 points), exporter bouton-v2.

### Avant d'imprimer

- ✅ Switches centrés dans la largeur de la carte NeoKey (10,75 au bord haut) : y_neokey est juste.
- ✅ Méplat de 7 mm : l'alésage est en D sur toute sa profondeur.

### Impression

- Profil 0.20mm Standard, plaque texturée.
- Coin de module, couleur du corps : façade contre le plateau (touche F, comme les capuchons), parois et plots vers le haut, sans support.
- Bouton (version 2, jeu 0,2), couleur d'accent : dessus contre le plateau, alésage vers le haut.
- Plots : dans Bambu Studio, 4 boucles de paroi (onglet Résistance) pour que les plots soient pleins.
- Montage : 8 vis M2 auto-taraudeuses de 6 mm, posées par le dos à travers les cartes. Carte de l'encodeur tournée de 90° : un connecteur côté écran, l'autre côté coins arrondis (trous symétriques, rien ne change dans la CAO).

### Premier test (2026-10-04)

- ✅ Alignement des switches et de l'axe, fenêtres sans frottement, hauteur des touches et accès au pouce gauche : validés.
- ❌ Plots Ø 3,6 / avant-trou 1,6 : le plastique éclate au vissage. → plaquette de plots : d_plot reste à 3,6, d_pilote passe à 1,8.
- ❌ 2 vis NeoKey sur 4 : les trous côté écran sont 1 mm plus haut. → trou_nk_y_haut = 2.
- ❌ Bouton : frotte la façade au clic, le clic ne passe pas. → bouton version 2, 2 mm sous le bouton.
- Câbles QT justes mais ça passe ; connecteurs face à face. → encodeur tourné de 90°.

### Deuxième test (2026-10-04) · coin VALIDÉ ✅

8 vis sans fissure, aucun contact des plots, clic de la molette franc sans frottement, bouton v2 bien tenu, fiche QT de l'encodeur côté écran.

### À noter après le deuxième test

- Fixation : les 8 vis prennent-elles, sans fissure ? Les cartes sont-elles fermes ? Serrer jusqu'au contact de la carte puis s'arrêter : trop de couple casse un plot entre deux couches.
- Plots : aucun contact avec les switches ni avec le corps de l'encodeur ?
- Bouton : le clic passe-t-il franchement, sans frotter la façade ? Le bouton tient-il toujours bien sur l'axe avec 6 mm d'alésage ?
- Câbles QT : le câble de l'encodeur sort-il bien côté écran ?

### Plaquette de plots · fichier plaquette-plots

Avant de réimprimer le coin complet : 3 plots identiques à ceux du coin, seul le diamètre change. 15 minutes d'impression.

Nom | Valeur | Rôle
l_plaque | 50 mm | Longueur de la plaquette
w_plaque | 16 mm | Largeur de la plaquette
ep_plaque | 2,5 mm | Comme la façade
h_plot | 8,5 mm | Comme les plots NeoKey
d_pilote | 1,8 mm | Avant-trou, le même pour les 3 plots
p_pilote | 6 mm | Profondeur de l'avant-trou

### Étapes dans Fusion · fichier plaquette-plots

1. Modifier les paramètres : créer les paramètres ci-contre.
2. Plaque : esquisse sur le plan XY, Rectangle 2 points depuis l'origine, l_plaque × w_plaque. Extruder de ep_plaque vers le haut.
3. Plots : esquisse sur le dessus de la plaque, 3 cercles centrés à y = 8 et x = 10, 25, 40, de Ø 3,6, 4,2 et 5 (cotes saisies en dur, c'est ce qu'on teste). Extruder en « Joindre » de h_plot.
4. Avant-trous : esquisse sur le bout des plots, 3 cercles de d_pilote concentriques, Couper de p_pilote.
5. Repères : esquisse sous la plaque, à 4 mm devant chaque plot, 1, 2 et 3 cercles Ø 1 espacés de 2,5 (1 point = Ø 3,6). Couper de 0,4.
6. Enregistrer sous cad/plaquette-plots, exporter en .3mf.

### Impression et test

- 0.20mm Standard, plaque texturée, plaquette à plat, plots vers le haut, 4 boucles de paroi.
- Visser une vis M2 de 6 mm dans chaque plot à travers un trou de coin de la carte de l'encodeur (1,6 mm d'épaisseur, comme au montage), serrer à fond, dévisser, revisser une fois.
- Noter pour chaque plot : fissure ou non, la vis tient-elle ferme.
- Règle de choix : garder le plus petit diamètre qui ne casse pas, pour laisser le plus de place aux switches et au corps de l'encodeur. Si Ø 3,6 tient avec l'avant-trou de 1,8, on garde 3,6.
