frederic-fradin/default-project/desktop-tool/docs/design/tenons-test.html

desktop-tool · pièce test P1 · cotes en mm

# Chevilles de station test

Fixation des éléments sur le socle percé (ADR 005, option B) : une cheville fendue, imprimée couchée, traverse la semelle de l'élément et se clipse dans un trou du socle. La pièce test comprend un bout de socle à 3 trous, un bout de semelle à 2 trous et 6 chevilles (2 par taille d'ergot).

## Montage en coupe

coupe 5:1détail 15:1ergot 0,4

Principe. La tête de la cheville est logée dans un lamage de la semelle, 0,2 mm sous la surface : en soulevant l'élément, la semelle emmène ses chevilles. Au bout, l'ergot passe le trou Ø 10 en rapprochant les deux bras, puis se détend dans la gorge Ø 10,8 creusée au fond du trou : c'est le clic.

Serrage. La tige (Ø 9,6) a 0,2 mm de jeu au rayon dans le trou. L'ergot dépasse le trou de e_ergot − 0,2 au rayon, soit 0 / 0,1 / 0,2 mm selon la variante, plus le resserrement habituel des trous imprimés (≈ 0,05 à 0,1 mm au rayon).

## Bout de socle et bout de semelle

échelle 2:1

Fidèles à la station. Pas de 20 mm, marge de 15 mm, socle de 10 mm, semelle de 3 mm : les bouts de test reprennent les cotes réelles, seule leur longueur est réduite.

## Cheville

échelle 5:1dessinée telle qu'imprimée

Pourquoi couchée. Les bras plient alors dans le plan des couches, là où le PLA est solide ; debout, ils plieraient entre deux couches et casseraient à la base. Les deux méplats de 0,5 mm donnent une face d'appui sur le plateau, et la fente est verticale, ouverte vers le haut : aucun support.

Conséquence. Dans l'axe des méplats, la cheville a ≈ 0,7 mm de jeu au rayon. C'est à observer pendant le test (voir « À noter »).

## Les trois variantes à imprimer

échelle 4:1vues côté tête

### Paramètres utilisateur Fusion

Nom | Valeur | Rôle
pas_grille | 20 mm | Entraxe des trous du socle · S
marge | 15 mm | Du bord au premier axe de trou · S
ep_socle | 10 mm | Épaisseur du socle · S
ep_semelle | 3 mm | Épaisseur de la semelle · S C
d_trou | 10 mm | Trou du socle et de la semelle · S C
p_trou | 6 mm | Profondeur du trou du socle · S C
e_gorge | 0,4 mm | Débord de la gorge au rayon · S
d_gorge | 10,8 mm | Formule d_trou + 2 * e_gorge · S
h_gorge | 2 mm | Hauteur de la gorge, au fond du trou · S
d_tete | 13 mm | Diamètre de la tête · S C
h_tete | 1 mm | Épaisseur de la tête · S C
jeu_lamage | 0,2 mm | Jeu autour et au-dessus de la tête · S C
d_lamage | 13,4 mm | Formule d_tete + 2 * jeu_lamage · S
p_lamage | 1,2 mm | Formule h_tete + jeu_lamage · S C
jeu_tenon | 0,2 mm | Jeu de la tige au rayon, règle des +0,2 · C
d_tige | 9,6 mm | Formule d_trou - 2 * jeu_tenon · C
jeu_fond | 0,3 mm | Écart entre le bout et le fond du trou · C
l_tige | 7,5 mm | Formule ep_semelle - p_lamage + p_trou - jeu_fond · C
l_fente | 7 mm | Longueur des bras, depuis le bout · C
e_fente | 2 mm | Largeur de la fente · C
meplat | 0,5 mm | Méplat de chaque côté, pour l'impression · C
l_ergot | 1,5 mm | 0,5 de rampe arrière + 0,4 de plat + 0,6 d'entrée · C
e_ergot | 0,2 / 0,3 / 0,4 mm | Saillie de l'ergot au rayon, une valeur par variante · C

S : fichier tenons-test (socle et semelle) · C : fichier cheville. Les paramètres « S C » prennent la même valeur dans les deux fichiers.

### Étapes dans Fusion · fichier tenons-test

1. Modifier › Modifier les paramètres : créer les paramètres marqués S.
2. Socle : esquisse sur le plan XY, rectangle à partir du centre, sur l'origine, de 2 * marge + 2 * pas_grille × 2 * marge (70 × 30). Extruder de ep_socle vers le haut. Congé de 3 sur les 4 arêtes verticales.
3. Trous : esquisse sur le dessus, 3 cercles de d_trou sur l'axe X, celui du milieu sur l'origine, les autres à pas_grille. Extruder en « Couper » de p_trou.
4. Gorges : esquisse sur le fond d'un trou, 3 cercles de d_gorge concentriques aux trous (le plan de l'esquisse sert aux trois). Extruder en « Couper » de h_gorge, flèche vers le haut, vers l'ouverture du trou.
5. Semelle : esquisse sur le plan XY, rectangle à partir du centre de 2 * marge + pas_grille × 2 * marge (50 × 30), son centre à 45 de l'origine sur l'axe Y. Extruder de ep_semelle, opération Nouveau corps. Congé de 3.
6. Trous de la semelle : esquisse sur son dessus, 2 cercles de d_trou à pas_grille l'un de l'autre, centrés sur la pièce. Extruder en « Couper », étendue Tout.
7. Lamages : nouvelle esquisse sur le dessus, 2 cercles de d_lamage concentriques. Extruder en « Couper » de p_lamage.
8. Renommer les corps socle et semelle, enregistrer, exporter en .3mf.

### Étapes dans Fusion · fichier cheville

1. Modifier › Modifier les paramètres : créer les paramètres marqués C, avec e_ergot = 0,2 mm.
2. Profil : esquisse sur le plan XZ. Avec l'outil Ligne, tracer d'un seul trait le demi-profil au-dessus de l'axe X (tableau ci-dessous), puis le coter avec les paramètres.
3. Créer › Révolution : ce profil, axe = axe X, 360°.
4. Méplats : esquisse sur le plan XZ, deux rectangles qui débordent la pièce, l'un au-dessus de z = d_tige / 2 - meplat, l'autre au-dessous de z = -(d_tige / 2 - meplat). Extruder en « Couper », étendue Symétrique, 20 mm.
5. Fente : esquisse sur le plan XY, rectangle de e_fente de large centré sur l'axe X, depuis x = h_tete + l_tige - l_fente jusqu'au-delà du bout. Extruder en « Couper », Symétrique, 20 mm.
6. Repère : esquisse sur la face extérieure de la tête, un cercle Ø 1 au centre. Extruder en « Couper » de 0,4.
7. Enregistrer, exporter en .3mf sous cheville-ergot-02. Puis passer e_ergot à 0,3 avec 2 points de repère, puis à 0,4 avec 3 points, et exporter chaque variante.

Point | x | Rayon
A · axe, face de la tête | 0 | 0
B · bord de la tête | 0 | d_tete / 2 = 6,5
C | h_tete = 1 | 6,5
D · début de la tige | 1 | d_tige / 2 = 4,8
E · pied de l'ergot | h_tete + l_tige - l_ergot = 7 | 4,8
F · sommet de l'ergot | E + 0,5 = 7,5 | d_tige / 2 + e_ergot
G | F + 0,4 = 7,9 | idem
H · bout | h_tete + l_tige = 8,5 | 4,8
I · axe, bout | 8,5 | 0

### Impression

- Profil 0.20mm Standard, plaque texturée, comme pour les touches.
- Socle et semelle : posés à plat, trous vers le haut, sans support. Le plafond de la gorge ne déborde que de 0,4 mm.
- Chevilles : modélisées couchées, elles arrivent déjà dans le bon sens. Vérifier qu'elles reposent sur un méplat et que la fente est verticale. Imprimer 2 exemplaires de chaque variante (touche + dans Bambu Studio pour ajouter une instance).
- Dans les réglages propres aux chevilles (clic droit sur l'objet), monter le nombre de parois à 4 : les bras sont alors pleins.

### À noter après le test

#### Chaque variante, seule dans le socle

- S'enfonce-t-elle à la main ? Sent-on un clic ?
- Tient-elle socle retourné ? Se retire-t-elle à la main ?
- Après 10 poses et retraits : bras blanchis, fissurés ou cassés ?

#### Semelle avec 2 chevilles de la meilleure variante

- Se pose-t-elle sur 2 trous sans forcer ? Tient-elle si on soulève le socle par la semelle ?
- Jeu ressenti dans l'axe des méplats ? Si oui, refaire l'essai avec une cheville tournée à 90°.
- Hors du socle, les chevilles tombent-elles de la semelle ?

#### Mesures

- Diamètre réel d'un trou du socle, au pied à coulisse, pour confirmer la règle des +0,2.
