frederic-fradin/default-project/desktop-tool/docs/design/capuchon-test.html

desktop-tool · pièce test P1 · cotes en mm

# Capuchon de touche test

Capuchon plat sans jupe pour switch Kailh BOX Brown, sur la NeoKey 1x4 (pas de 19 mm). Trois exemplaires à imprimer, un par jeu de croix ; le nombre de barres gravées sert de repère. Cotes tirées des mesures du 2026-10-03.

## Vues et coupe

échelle 4:1jeu de croix 0,2

## Détail de la croix et montage sur le switch

croix 10:1montage 4:1

Course. Au repos, le dessous du capuchon repose sur le haut du carré (box), à 15,5 mm au-dessus de la carte. Touche enfoncée, le carré affleure le boîtier : le dessous du capuchon arrive à 11,5 mm, au niveau du dessus du boîtier. Le capuchon n'ayant pas de jupe, rien ne peut toucher le boîtier avant la fin de la course.

Boîtier. Sa pente réelle n'est pas mesurée : il est dessiné simplifié, de 15,5 mm à la base à 10,1 mm en haut.

## Les trois variantes à imprimer

échelle 3:1

### Paramètres utilisateur Fusion

Nom | Valeur | Rôle
pas_touche | 19 mm | Entraxe des switches mesuré
jeu_touches | 1 mm | Écart entre deux touches voisines
cote_touche | 18 mm | Côté du dessus, formule pas_touche - jeu_touches
r_coin | 1,5 mm | Arrondi des 4 coins
ep_touche | 3 mm | Épaisseur du plateau
d_pied | 5,5 mm | Pied rond, dans le carré de 6 mm
h_pied | 3,5 mm | Profondeur de croix 3,6 − 0,1
croix_l | 4 mm | Longueur d'une branche mesurée
croix_e | 1,2 mm | Largeur d'une branche mesurée
jeu_croix | 0,2 / 0,3 / 0,4 mm | Une valeur par variante
grav_prof | 0,6 mm | Profondeur des barres gravées

### Étapes dans Fusion

1. Modifier › Modifier les paramètres : créer les paramètres du tableau.
2. Esquisse sur le plan XY : rectangle centré cote_touche × cote_touche. Extruder de ep_touche vers le haut.
3. Congé de r_coin sur les 4 arêtes verticales.
4. Esquisse sur la face du dessous : cercle centré de d_pied. Extruder de h_pied vers le bas, en mode « Joindre ».
5. Esquisse sur le bout du pied : deux rectangles centrés en croix, croix_l + jeu_croix × croix_e + jeu_croix. Extruder en mode « Couper » de h_pied.
6. Esquisse sur le dessus : barre(s) verticale(s) de 0,8 × 5, écart 1,5, centrées. Extruder en mode « Couper » de grav_prof.
7. Enregistrer, exporter en .3mf. Puis passer jeu_croix à 0,3 avec 2 barres, puis à 0,4 avec 3 barres, et exporter chaque variante.

### Impression

- Les trois capuchons sur le même plateau, face visible contre le plateau : le pied pointe vers le haut et la croix est imprimée à plat.
- Point de vigilance : les parois du pied ne font que 0,65 mm au bout des branches. Vérifier dans l'aperçu du trancheur qu'elles sont bien imprimées.

### À noter après le test

- Le jeu de croix retenu : le capuchon s'enfonce en forçant un peu, ne bouge pas et se retire à la main.
- La netteté des barres gravées.
- La sensation sous le doigt : taille 18 × 18, épaisseur de 3 mm.
- La LED de la NeoKey : se voit-elle à travers ou autour du capuchon ?
