frederic-fradin/default-project/(commit log)

2026-09-26 Add desktop-tool project: framing, design mockups and BOM
    - Framing document validated (v1.1): goals, scope, architecture, schedule, risks
    - Decision records: device + PC companion architecture, Fusion CAD,
    module + stand with battery/wireless provisions
    - Blueprint mockups (module, stand with embedded module, colour palettes)
    - Bill of materials with order tracking, project journal, design references
2026-09-27 desktop-tool: P1 first print tests, neutral keys with on-screen labels
    - ADR 004: keys 1-3 marked with 1/2/3 engraved bars, key 4 with a home
    icon; each key's function is shown on the e-paper next to it
    - Cadrage v1.4: engraved (not raised) symbols, keys printed face down,
    colours reopened between black + red and white + orange
    - Journal: Fusion setup, test plate modelled and printed
2026-09-27 desktop-tool: budget tracking with actual spend (149.64 EUR of 150)
    Record amounts paid on the Amazon and DigiKey orders, compare them to
    estimates in the framing doc (v1.5), and fix STEMMA QT 4209 cable
    quantity (1 ordered, not 2).
2026-09-27 desktop-tool: add test plate CAD files (Fusion + 3MF)
    First printed part of P1: colour swatches, raised text, magnet
    pocket tolerances.
    [plaquette-test.3mf, plaquette-test.f3d]
2026-09-27 desktop-tool: modular desk station (ADR 005), discreet key symbols
    - Mockup: small engraved key symbols without fill, on-screen label column
    aligned with keys (ADR 004)
    - Replace the massive triangle stand with a modular station: base plate
    with pen groove and 20 mm attachment grid, clip-on module stand (magnetic
    USB-C in the blade) and MagSafe stand (iPhone Pro, portrait)
    - ADR 005, cadrage v1.6, journal entry
2026-09-27 desktop-tool: landscape module (ADR 006), perforated 12-column station
    - Mockup: module rotated 90 degrees left (screen on top, wheel bottom-left, keys in a row bottom-right, key labels at the bottom of the screen)
    - Station: base 250 x 90 with 48 round holes, 4 round pegs per element, softened seats, no front lip on the phone stand, iPhone 13 Pro, 2 free columns; pen groove removed
    - ADR 006, ADR 005 revised, ADR 003 status, cadrage v1.8, journal
2026-10-02 desktop-tool: log reception of all v1 parts except T5 board
2026-10-03 desktop-tool: log magnet seat test, keep 6.2 mm hole
2026-10-03 desktop-tool: add keycap test drawing and Kailh BOX switch measurements
2026-10-03 desktop-tool: log print profile for keycap test (0.20 mm Standard)
2026-10-03 desktop-tool: log first keycap fit (0.2 mm cross clearance OK)
2026-10-03 desktop-tool: settle keycap cross clearance at 0.2 mm
2026-10-03 desktop-tool: validate keycap test (clean engraving, textured plate kept)
2026-10-03 desktop-tool: log full set of 4 keycaps printed OK
2026-10-03 desktop-tool: add keycap set CAD (Fusion f3d + 3mf)
    [capuchons.3mf, capuchons.f3d]
2026-10-03 desktop-tool: switch station fixing to separate split pins, add test drawing
2026-10-03 desktop-tool: put station socket principle and pin test on hold
2026-10-03 desktop-tool: correct NeoKey hole positions (centres 19 / 1.3 mm)
2026-10-03 desktop-tool: fix NeoKey hole offset from long sides (3 mm)
2026-10-03 desktop-tool: log rotary encoder board measurements
2026-10-03 desktop-tool: log rotary encoder body, bushing and shaft measurements
2026-10-03 desktop-tool: add module corner test drawing (NeoKey, encoder, knob)
2026-10-03 desktop-tool: module corner test, centred switches and full-depth D bore
2026-10-03 desktop-tool: log knob print, align variant dots step with method used
2026-10-03 desktop-tool: log knob fit with 0.2 mm clearance
2026-10-03 desktop-tool: settle knob bore clearance at 0.2 mm
2026-10-03 desktop-tool: log module corner test print started
2026-10-03 desktop-tool: add module corner and knob CAD (Fusion f3d)
    [bouton-molette.f3d, coin-module.f3d]
2026-10-04 desktop-tool: log module corner fit test, revise plots, NeoKey holes and knob
2026-10-04 desktop-tool: add plot test plate CAD, update module corner and knob v2
    [bouton-molette.f3d, coin-module.f3d, plaquette-plots.3mf, plaquette-plots.f3d]
2026-10-04 desktop-tool: settle plot diameter at 3.6 mm after plot test plate
    [bouton-molette.3mf]
2026-10-04 desktop-tool: add fit mock-up sheet from official T5 drawings, save corner v2 CAD
    [bouton-molette.3mf, bouton-molette.f3d, coin-module.3mf, coin-module.f3d]
2026-10-04 desktop-tool: wire I2C through T5 P5 port, add JST PH to QT cable to BOM
2026-10-04 desktop-tool: model fit mock-up with provisional T5 dimensions
    [module-maquette.3mf, module-maquette.f3d]
2026-10-04 desktop-tool: add colour test facade tile
    [tuile-couleur.3mf, tuile-couleur.f3d]
2026-10-05 desktop-tool: log full set of Charcoal Black keycaps printed
2026-10-05 desktop-tool: accept ADR 007, PC-rendered pages and PC/device message protocol
2026-10-05 desktop-tool: add companion app and device simulator (ADR 007 protocol)
